reakain/TeensyCanBot/(commit log)

2020-05-16 initial commit with functional code by maybe inverted motor pins
    [TeensyBot.ino, motorFunctions.ino]
2020-05-16 have correct motor functionality. had to move pwm to pin 4 because of dead pin, now motors share a pwm timer
    [TeensyBot.ino]
2020-05-17 Cleaned up documentation and organization, added circuit diagram and pictures
